SolviX-IoT/nou_hub_senzoor_pairing/ISTORIC.md

# ISTORIC — SolviX HUB + SENZOR

> Arhiva proiectului: **de ce** arata codul asa cum arata. Nu se incarca
> automat in context — se deschide cand ai nevoie de motivul din spatele unei
> decizii, cand un simptom seamana cu ceva ce s-a mai intamplat, sau cand un
> mesaj de commit citeaza o eticheta `F-0xx`.
>
> Referinta activa (pini, protocol, reguli) este in [CLAUDE.md](CLAUDE.md).
> Starea de acum (cifre, versiuni de format) este in [MEMORY.md](MEMORY.md).
>
> **Nicio intrare nu se sterge.** Ce nu mai este valabil se marcheaza
> *ISTORIC*, ca etichetele din mesajele de commit sa ramana rezolvabile.

---

## 1. Constrangerile care au modelat implementarea

Acestea vin din hardware-ul real si explica de ce solutia nu arata ca o
retea LoRa "de manual".

### 1.1. Flash si RAM foarte mici pe senzor — cifre masurate, nu estimate

`PIC16LF1508` are **4096 de cuvinte de flash si 256 de octeti de RAM**
(`ROMSIZE=1000`, `RAMBANK=20-7F,A0-EF,120-16F` in fisierul de device support
al lui XC8: 240 de octeti bancati + 16 comuni). O versiune anterioara a
documentatiei scria 512 B de RAM — era gresit, si din acea eroare a pornit
toata problema de incadrare (F-025).

**Aici s-a consumat toata marja, si de aceea nu mai exista criptografie in
proiect.** Istoricul incadrarii:

| varianta | flash (words) | RAM (octeti) |
|---|---|---|
| AES-128, cum a fost scrisa initial, `-O2` | 5426 | 446 |
| AES cu toate solutiile de rezerva aplicate simultan | 4325 | 286 |
| XTEA-128, dupa F-024 | 3761 | 250 |
| XTEA + pairing manual + somn + 5 senzori | 3876 | 232 |
| **fara criptografie (acum)** | **2395** | **95** |

AES nu incapea nici macar cu toate solutiile de rezerva: doar cele doua tabele
de substitutie ocupa 512 cuvinte, un sfert din tot flash-ul, inainte de orice
linie de cod (F-024). XTEA-128 a incaput, dar la 3876 din 3968 de cuvinte
utilizabile — **92 de cuvinte marja** — nu mai incapea nicio functionalitate
noua. La 2026-08-29 criptografia a fost scoasa (F-038), ceea ce a eliberat
**1481 de cuvinte si 137 de octeti**.

**Pretul: reteaua NU mai este autentificata.** Nu exista MIC, cheie sau nonce.
Oricine are un radio LoRa cu aceiasi parametri poate injecta o temperatura
falsa pentru orice senzor, poate dezinrola orice placa cu patru octeti
(`A5 13 <DevAddr> 02`), poate inrola o placa falsa cat timp fereastra de
pairing este deschisa (DevEUI-ul este ghicibil: `"SOLVIX" | 0x00 | numar`), si
poate rejuca orice pachet capturat. Singura limitare ramasa pe calea de date
este frame counter-ul strict crescator. In plus, `RegSyncWord` ramane `0x12`,
valoarea implicita a bibliotecii: inainte, MIC-ul filtra si emitatorii straini
care nimereau aceiasi parametri.

**Nu compensa cu nimic facut in casa.** Un pseudo-MIC de o suta de cuvinte
care nu opreste pe nimeni este mai rau decat o absenta onesta, fiindca cineva
se va baza pe el. Criptografia se reintroduce la upgrade-ul de microcontroller,
din commit-ul `a710142`, care este ultima stare care o contine.

**`-O2` ramane obligatoriu si regiunea HEF ramane rezervata.** Cu marja de
acum firmware-ul ar incapea probabil si cu `-O0`, dar cele doua setari nu se
schimba "fiindca oricum e loc": rezervarea HEF este singurul lucru care
garanteaza ca linkerul nu pune cod peste memoria ne-volatila (F-027).

Daca vreodata nu mai incape nici asa, ramane migrarea pe **PIC16LF1509**
(8K words, 512 B RAM), pin-compatibil — maparea de pini ramane valabila bit cu
bit, dar `HEF_BASE` devine `0x1F80`.

### 1.2. `SLEEP` nu este acelasi lucru cu taierea alimentarii

Distinctia asta decide schema frame counter-ului.

**Ce se intampla acum:** inrolat, senzorul executa `SLEEP` intre transmisii si
se trezeste pe watchdog. Durata **nu este aceeasi pe toate placile**:
`SLEEP_WAKEUPS_BASE` + `(DevAddr - 1)` + un jitter aleator de 0..3 treziri,
adica ~23 s pentru senzorul #1 fara jitter si pana la ~38 s pentru senzorul #5
cu jitter maxim (F-036). `SLEEP` pe PIC16 **pastreaza RAM-ul si registrele** —
procesorul doar isi opreste ceasul. Deci schema din F-022 ramane valabila
neschimbata: counter-ul traieste in RAM si se salveaza in HEF doar la fiecare
`FCNT_CHECKPOINT_EVERY` = 50 de pachete. **Nu** se scrie la fiecare ciclu de
somn; ar consuma HEF-ul degeaba.

**Ce ar fi altceva:** un regim in care **alimentarea se taie** intre transmisii
(un timer extern de tip PTC/latch care scoate VDD). Acolo fiecare trezire ar fi
un cold boot cu RAM-ul pierdut: counter-ul ar trebui scris la fiecare ciclu,
inelul de sloturi din HEF ar trebui marit (sau inlocuit cu un FRAM extern), iar
inrolarea ar trebui incadrata intr-o fereastra de alimentare. **Nu este cazul
astazi.**

Somnul se aplica doar in `DEV_STATE_OPERATING`. In `DEV_STATE_IDLE` si in
`DEV_STATE_JOINING` senzorul ramane treaz, fiindca acolo trebuie sa asculte
butonul 2 si sa poata face join.

### 1.3. Senzorul era doar TX, cu polling, fara DIO0 si fara RESET cablat

Pentru pairing a trebuit adaugat mod RX in driver: `LoRa_Receive()`, cu RX
continuu si polling pe `RxDone` / `PayloadCrcError`, citire din `RegFifo` de la
`FifoRxCurrentAddr`.

### 1.4. Pe hub, SPI este partajat cu ENC28J60

Tot traficul radio trece prin `SpiBus` (`claimLoRa()` / `SpiGuard`), receptia
este prin polling cu `receiveRaw()`, emisia binara prin `sendRaw()`, LED-urile
doar prin modulul `Leds`, si nu se apeleaza niciodata `LoRa.end()` /
`SPI.end()`.

---

## 2. Cronologie

| Data | Etichete | Ce s-a intamplat |
|---|---|---|
| — | F-001…F-020 | Mostenite din `teste-sistemcomplet/`: bug-urile de SPI partajat, de retea si de firmware de baza |
| — | F-021…F-023 | Faza de proiectare a pairing-ului: capcane prinse inainte de a ajunge pe placa |
| 2026-08-23 | F-024…F-029 | Pairing criptat, incadrat in PIC16LF1508: AES inlocuit cu XTEA-128, harta HEF corectata, regiunea HEF rezervata din linker |
| 2026-08-25 | F-030 | Pairing manual pe senzor, declansat din butonul 2 |
| 2026-08-25 | F-031 | Dezinrolare confirmata pe hub: RESET retrimis pana la tacere |
| 2026-08-25 | F-032 | Fereastra de downlink se deschide imediat dupa TX |
| 2026-08-25 | F-033 | Capcana de build: MPLAB X programa cod vechi |
| 2026-08-26 | *(fara F)* | TPL5110 scos din proiectare — vezi 2.1 |
| 2026-08-26 | F-034 | Somn intre transmisii pe senzor |
| 2026-08-26 | F-035…F-037 | Pana la 5 senzori pe acelasi hub |
| 2026-08-29 | F-038 | Criptografia scoasa, pairing-ul pastrat |
| 2026-09-01 | F-039…F-042 | Hub-ul nu mai este o suita de teste: runtime permanent, retea la pornire si bootstrap in cloud (health + provisioning) |
| 2026-09-01 | F-043 | Prima rulare cu serverul real: backoff-ul nu crestea si hub-ul isi intretinea singur blocajul de rate limiting |
| 2026-09-01 | F-044 | Campurile identitatii, dimensionate din estimare: lifecycleStatus nu incapea cu un caracter |
| 2026-09-01 | F-045 | Consola neblocanta nu executa nicio comanda pe "No line ending" - regresie din F-040 |
| 2026-09-01 | F-046 | Curatenie: consola redusa la 3 comenzi, cod mort scos, Blocked devine asteptare lunga |

### 2.1. 2026-08-26 — TPL5110 scos din proiectare *(fara eticheta F)*

Componenta nu mai este pe placa, deci a disparut si din cod: cele trei scrieri
de registre din `Board_Initialize()`, blocul de `#define` `TPL5110_DONE_*`,
notele din antetul lui `main.c`, testul `main_powercycle_test.c.bak` si
datasheet-ul din `senzor/Datasheets/` (folderul a ramas gol si a fost sters).

**RC1 este acum un pin liber si nu primeste cod:** ramane pe configuratia MCC
din `pins.c`, adica intrare analogica, ceea ce pentru un pin neconectat este
exact starea buna — bufferul digital de intrare este dezactivat, deci un nivel
flotant nu consuma curent.

F-011, F-012 si F-018 au fost marcate ISTORIC in loc sa fie sterse, ca
etichetele din mesajele de commit sa ramana rezolvabile; F-013 si F-014 raman
documentatie vie, fiindca lectiile lor nu tin de TPL5110.

Castigul de memorie este cel asteptat de la trei scrieri de registre:
**-5 cuvinte**, 3921 -> 3916.

**Ramas de facut manual:** `PINOUT_config.pdf` inca arata RC1 -> TPL5110.

---

## 3. Catalogul F-001 … F-046

Fiecare intrare spune **simptomul**, **cauza** si **fixul**, ca sa nu se repete
aceleasi greseli.

### F-001 — Modulele SPI se calca pe MISO (hub)
- **Simptom:** date de gunoi citite de la ENC28J60 sau de la LoRa, aleatoriu.
- **Cauza:** un slave SPI elibereaza MISO doar cat timp CS-ul lui este HIGH. La boot, ambele CS-uri erau flotante, deci ambele module puteau trage simultan de aceeasi linie.
- **Fix:** `SpiBus::begin()` face ambele CS-uri OUTPUT si HIGH **inainte** de orice trafic; `claimEthernet()` / `claimLoRa()` ridica CS-ul celuilalt modul inainte ca un test sa preia bus-ul.

### F-002 — `SPI.begin()` apelat de mai multe ori (hub)
- **Simptom:** maparea de pini se pierdea dupa ce un test reinitializa bus-ul.
- **Fix:** `SPI.begin()` se apeleaza **o singura data**, din `setup()`, cu ultimul argument `-1` ca driverul ESP32 sa nu preia niciun pin drept CS hardware.

### F-003 — `LoRa.end()` oprea si Ethernet-ul (hub)
- **Simptom:** dupa oprirea testului LoRa, ENC28J60 nu mai raspundea.
- **Cauza:** `LoRa.end()` inchide magistrala SPI a intregului ESP32.
- **Fix:** nu se apeleaza niciodata `LoRa.end()` sau `SPI.end()`; pentru oprirea radioului se foloseste `LoRa.sleep()`.

### F-004 — Acces SPI din intrerupere (hub)
- **Simptom:** coruperea transferurilor Ethernet aflate in desfasurare.
- **Cauza:** `LoRa.onReceive()` ruleaza callback-ul pe intreruperea de pe DIO0, care poate cadea fix in mijlocul unui transfer Ethernet.
- **Fix:** receptia se face prin **polling** cu `LoRa.parsePacket()`.

### F-005 — CS-ul Ethernet confundat cu GPIO5 (hub)
- **Simptom:** ENC28J60 mut.
- **Fix:** CS_ETH este **GPIO4**; GPIO5 este NSS-ul LoRa. Documentat explicit in `Config.h` si in README.

### F-006 — ICMP nu functioneaza pe ENC28J60 (hub)
- **Simptom:** ping-ul esua desi reteaua era in regula.
- **Cauza:** ENC28J60 nu raspunde la ICMP fara o librarie suplimentara, adesea instabila.
- **Fix:** testul de internet foloseste o cerere **HTTP GET**, care valideaza simultan DNS, rutare si TCP.

### F-007 — DHCP blocant (hub)
- **Simptom:** meniul serial devenea inutilizabil zeci de secunde.
- **Fix:** `Ethernet.begin(MAC, timeoutMs)` — al doilea parametru limiteaza asteptarea.

### F-008 — GPIO34/35 flotante (hub)
- **Simptom:** butoanele "se apasau singure".
- **Cauza:** GPIO34 si GPIO35 sunt **input-only** si nu au pull-up/pull-down intern.
- **Fix:** rezistor extern obligatoriu pe placa. Testul de butoane numara tranzitiile tocmai ca sa faca vizibil defectul. **In plus, in acest proiect:** butonul 1 (care deschide pairing-ul) este ascultat doar cand nu ruleaza niciun test sau cand ruleaza testul 8, ca zgomotul de pe o linie flotanta sa nu comute testele singur.

### F-009 — Mod SPI gresit pentru SX1276 (senzor)
- **Simptom:** `RegVersion` citea altceva decat `0x12`.
- **Cauza:** MSSP-ul pornea intr-un mod SPI care nu corespunde cu SX1276.
- **Fix:** dupa `Lora_SPI.Open(0)` se forteaza explicit **SPI mode 0**: `SSP1CON1bits.CKP = 0`, `SSP1STATbits.CKE = 1`.

### F-010 — Verificarea prezentei radioului (senzor)
- **Fix:** se citeste `RegVersion (0x42)` si se cere `0x12`. Daca nu se potriveste, versiunea citita se **clipeste pe LED in hexazecimal** (`LoRa_ShowVersionError`), in loc sa se blocheze mut.

### F-011 — DONE ignorat de TPL5110 (senzor)
> **ISTORIC.** TPL5110 a fost scos din proiectare la 2026-08-26 si nu mai
> este pe placa. Intrarea se pastreaza pentru trasabilitatea etichetelor
> F-0xx din mesajele de commit; codul descris aici nu mai exista.
- **Simptom:** placa nu se oprea la apasarea butonului.
- **Cauza:** TPL5110, sectiunea 8.5.2 din datasheet: "DONE signals received while the DELAY/M_DRV is HIGH are ignored". M_DRV are 20 ms de debounce pe ambele fronturi.
- **Fix:** se asteapta eliberarea butonului, apoi `TPL5110_MDRV_SETTLE_MS = 60 ms`, abia apoi se semnaleaza DONE.

### F-012 — Un singur front DONE nu e suficient (senzor)
> **ISTORIC.** Vezi nota de la F-011: TPL5110 nu mai este pe placa.
- **Cauza:** DONE este declansat pe front (min. 100 ns) si doar primul front dintr-un interval este procesat.
- **Fix:** se trimit **10 pulsuri** (`TPL5110_DONE_PULSES`) in loc de un singur nivel.

### F-013 — Blocaj in SPI daca MSSP e dezactivat (senzor)
- **Simptom:** apasarea butonului bloca firmware-ul.
- **Cauza:** `SPI1_ByteExchange` asteapta `SSP1IF` la nesfarsit daca MSSP-ul este oprit.
- **Fix:** niciun acces SPI daca `loraReady == 0`. In acest proiect regula acopera si calea de pairing: bucla de JOINING nu emite si nu asculta daca radioul nu a raspuns.

### F-014 — Nu se distingea defectul de firmware de cel de cablaj (senzor)
- **Fix:** LED-ul de alimentare se aprinde imediat la start si nimic nu il mai atinge.

### F-015 — Bounce la butoane (senzor)
- **Fix:** `Button_Pressed()` citeste, asteapta 20 ms, reciteste; nepotrivirea inseamna bounce si se ignora.

### F-016 — Fara virgula mobila pe PIC16 (senzor)
- **Problema:** formula Steinhart / beta cere `log()` si `exp()`; libraria math in virgula mobila nu incape in cei 4K words alaturi de driverul LoRa.
- **Fix:** conversie prin **tabel de cautare cu interpolare liniara** in aritmetica pe intregi: 25 de intrari de la −20 °C la +100 °C, pas de 5 °C.

### F-017 — Fara timer hardware (senzor)
- **Constrangere impusa:** Timer0/1/2 nu sunt configurate.
- **Fix:** intervalul de transmisie se obtine cu o bucla software de pasi de 10 ms, care permite si verificarea butonului intre pasi.

### F-018 — RC1 (DONE) trebuie tinut LOW cand timerul nu e folosit (senzor)
> **ISTORIC.** TPL5110 a fost scos din proiectare la 2026-08-26. RC1 este
> acum un pin liber, fara cod in `main.c`: ramane pe intrare analogica din
> configuratia MCC, ceea ce pentru un pin neconectat este starea corecta —
> bufferul digital este dezactivat, deci un nivel flotant nu consuma curent.
- **Problema:** codul nu face power-cycle, dar RC1 este in continuare legat la pinul DONE al TPL5110. Lasat flotant sau HIGH, ar putea taia alimentarea in mijlocul unei transmisii — sau in mijlocul unei scrieri in HEF, ceea ce ar lasa un rand pe jumatate scris.
- **Fix:** `main()` configureaza RC1 ca iesire digitala si il tine **LOW permanent**.

### F-019 — `String` nu poate transporta un pachet binar (hub)
- **Simptom:** un pachet care contine octetul `0x00` ar fi fost trunchiat la receptie.
- **Cauza:** `LoRaRadio::receive()` acumuleaza octetii intr-un `String`, care trateaza `0x00` drept terminator de sir.
- **Fix:** `LoRaRadio::receiveRaw()`, care scrie intr-un buffer de `uint8_t`. **Extins in acest proiect pe emisie:** `JOIN_ACCEPT` si `CMD_DOWN` contin `0x00` in padding si in contoare, deci a fost adaugat si `LoRaRadio::sendRaw()`. `sendText()` ramane pentru testele de legatura cu text.

### F-020 — Cod nou livrat in foldere paralele in loc sa extinda proiectul
- **Simptom:** functionalitatea de temperatura a fost livrata initial ca `senzor_temp/` si `hub_lora_rx/`, doua foldere noi langa `senzor/` si `hub/`.
- **Cauza:** structura existenta nu a fost respectata. Rezultatul erau doua seturi de definitii de pini si doua initializari de driver, care ar fi divergat la prima modificare.
- **Fix:** codul a fost mutat in proiectele existente. **Regula pentru viitor, respectata si de pairing:** functionalitatea noua intra in `senzor/main.c` si in module noi din `hub/SolvixHub_Tests/`; nu se creeaza foldere paralele.

### F-021 — Un fisier `Crypto.h` propriu ar fi ascuns biblioteca `Crypto` (hub)
> **ISTORIC.** Wrapper-ul `HubCrypto.*` a disparut odata cu criptografia
> (F-038). Lectia despre calea de include ramane valabila pentru orice
> fisier nou din folderul sketch-ului.
- **Simptom (anticipat la proiectare):** eroare de compilare in interiorul bibliotecii `Crypto` (Rhys Weatherley), care nu isi mai gaseste propriile declaratii.
- **Cauza:** Arduino IDE pune folderul sketch-ului **inaintea** folderelor de biblioteci in calea de include. Un `Crypto.h` al nostru ar fi fost gasit primul si de biblioteca, atunci cand ea include `<Crypto.h>`.
- **Fix:** wrapper-ul s-a numit `HubCrypto.h` / `HubCrypto.cpp`, cu motivul scris in antetul fisierului.

### F-022 — Scrierea frame counter-ului la fiecare pachet ar consuma HEF-ul (senzor)
- **Simptom (anticipat):** dupa cateva luni de functionare, scrierile in HEF ar fi inceput sa esueze in tacere, iar senzorul ar fi reluat pairing-ul la fiecare pornire.
- **Cauza:** HEF suporta ~100.000 de cicluri de stergere/scriere pe rand. Un pachet la 5 secunde inseamna 17.280 de scrieri pe zi: sub 6 zile pe un singur rand.
- **Fix:** counter-ul sta in RAM (senzorul e alimentat permanent) si se salveaza doar la fiecare `FCNT_CHECKPOINT_EVERY` = 50 de pachete, prin rotatie in sloturile inelului. La cold boot se sare inainte cu 50, ca sa nu se reutilizeze nicio valoare. Rezulta ~345 de scrieri pe zi impartite la 2 randuri (vezi F-026 pentru de ce sunt 2, nu 4), adica peste 500 de zile pe rand.

### F-023 — Payload-ul decriptat nu trecea de checksum, fara niciun indiciu (hub)
> **ISTORIC.** `PAIRING_ENCRYPT_PAYLOAD` nu mai exista (F-038), deci cauza
> descrisa aici nu mai poate aparea.
- **Simptom (anticipat la proiectare):** MIC valid, deci pachetul chiar vine de la senzorul inrolat, dar `decode()` il respinge. Simptomul arata identic cu un senzor defect.
- **Cauza posibila:** `PAIRING_ENCRYPT_PAYLOAD` are valori diferite pe hub si pe senzor, deci hub-ul "decripteaza" un text care era deja in clar (sau invers).
- **Fix:** `TestPairing` trata acest caz separat de un MIC gresit, spunea explicit ce sa verifice si afisa octetii obtinuti.

### F-024 — AES-128 nu incape in PIC16LF1508
*(2026-08-23)*
- **Simptom:** proiectul nu link-edita deloc pentru `16LF1508`. Prima eroare era in RAM (`no space for auto/param main@tempPacket`), iar dupa ce se elibera RAM aparea un val de `can't find N words for psect ... in class CODE`.
- **Cauza:** firmware-ul cu AES-128 + AES-CMAC + AES-CTR cere **5426 de cuvinte de program si 446 de octeti de RAM** (masurat cu `xc8-cc` v3.10, `-O2`, compiland pentru `16LF1509` care are acelasi nucleu dar memorie mai mare — pe `16LF1508` link-editarea esueaza si nu da nicio cifra). Device-ul are 4096 de cuvinte si 256 de octeti. Nici macar cu toate cele trei solutii de rezerva prevazute in proiectare aplicate simultan nu se cobora sub **4325 de cuvinte / 286 de octeti**. Numai cele doua tabele de substitutie ale AES ocupa 512 cuvinte.
- **Fix:** cifrul a fost inlocuit cu **XTEA-128** (bloc de 64 de biti, cheie de 128, 32 de runde, `DELTA = 0x9E3779B9`). XTEA nu are niciun tabel si are nevoie doar de cifrare, fiindca MIC-ul (CBC-MAC) si criptarea (CTR) se construiesc amandoua peste ea. Rezultat: **3761 de cuvinte si 250 de octeti**, cu pairing-ul, cheia de sesiune, anti-replay-ul si criptarea payload-ului toate pastrate. `JOIN_ACCEPT` s-a scurtat de la 22 la 10 octeti.
- **De retinut:** CBC-MAC-ul simplu (fara subcheile CMAC) era sigur acolo **doar** pentru ca fiecare tip de mesaj avea lungime fixa si octetul `TYPE` se afla in primul bloc acoperit. Daca se reintroduce cifrul si se adauga un mesaj de lungime variabila, constructia trebuie schimbata.

### F-025 — RAM-ul lui PIC16LF1508 documentat gresit ca 512 B
*(2026-08-23)*
- **Simptom:** toate estimarile de incadrare erau optimiste cu un factor de doi, iar buffer-ele fusesera dimensionate dupa ele.
- **Cauza:** documentatia si comentariile din `main.c` scriau 512 B. In realitate `RAMBANK=20-7F,A0-EF,120-16F` inseamna **240 de octeti bancati + 16 comuni = 256**. (512 B are `PIC16LF1509`.)
- **Fix:** cifra a fost corectata peste tot, iar consumul a fost taiat acolo unde chiar conta: cheia extinsa a disparut (XTEA nu are program de chei), `hefRowBuffer` tine doar octetii folositi in loc de tot randul de 32 (restul latch-urilor primesc `0xFF` direct in `HEF_WriteRow`), iar buffer-ele de pachete au fost dimensionate dupa noile lungimi.

### F-026 — Randul de HEF are 32 de cuvinte, nu 16
*(2026-08-23)*
- **Simptom (prins inainte de a ajunge pe placa):** harta HEF folosea 8 regiuni de cate 16 cuvinte, iar scrierea "randului" de la `0x0F90` ar fi sters de fapt tot blocul `0x0F80`–`0x0F9F` — adica DevEUI-ul odata cu el. Senzorul si-ar fi pierdut identitatea la prima pornire, tacut.
- **Cauza:** dimensiunea randului fusese scrisa ca **presupunere** in proiectare si nu fusese verificata.
- **Fix:** valoarea reala este in fisierul de device support al lui XC8, `PIC12-16F1xxx_DFP/.../dat/ini/16lf1508.ini`: `FLASH_ERASE=20` si `FLASH_WRITE=20`, hexazecimal, adica **32 de cuvinte**. `HEF_ROW_WORDS` este acum 32, iar harta are 4 randuri. Ca efect secundar bun, o inrolare inseamna o singura stergere+scriere in loc de doua.

### F-027 — Linkerul plasa cod chiar in regiunea HEF
*(2026-08-23)*
- **Simptom (demonstrat pe fisierul de simboluri, inainte de a ajunge pe placa):** `Packet_BuildDataEnc` se termina la `0x0F9A` si `SPI1_Open` incepea acolo — adica exact peste `0x0F80`–`0x0FFF`. Prima scriere in HEF si-ar fi sters propriul cod si placa ar fi devenit un caramizi la prima inrolare.
- **Cauza:** proprietatea `code-model-rom` a proiectului MPLAB X era goala, deci linkerul avea voie sa foloseasca toata memoria de program, inclusiv ultimele 128 de cuvinte pe care firmware-ul le foloseste ca memorie ne-volatila.
- **Fix:** `code-model-rom = default,-f80-fff` in `senzor/nbproject/configurations.xml` (echivalentul lui `--ROM=default,-f80-fff`). Verificat dupa fix: ultima instructiune este la `0x0F7F`, deci regiunea HEF este curata. **Aceeasi rezervare trebuie refacuta daca cineva recreeaza proiectul MPLAB X de la zero.**

### F-028 — Aritmetica pe 32 de biti manca flash-ul pe PIC16
*(2026-08-23)*
- **Simptom:** functii banale ieseau enorme: `Xtea_LoadKey` 126 de cuvinte, `Nvm_LoadFrameCounter` 194, `NTC_AdcToTempX100` 207 plus inca 172 pentru rutinele `___aldiv` si `___lmul` din biblioteca.
- **Cauza:** PIC16 are un acumulator de 8 biti. Fiecare deplasare a unui `uint32` cu un numar de pozitii devine o bucla din biblioteca XC8, iar o impartire pe 32 de biti este o rutina intreaga. Impachetarea si despachetarea big-endian scrise "cu shift-uri" costau singure peste 300 de cuvinte.
- **Fix, in doua locuri:**
  1. **Cifrul** folosea uniunea `Word32 { uint32_t word; uint8_t byte[4]; }`. Conversiile big-endian devin mutari de octeti, fara nicio deplasare pe 32 de biti.
  2. **Interpolarea NTC** se face integral pe 16 biti, in doi pasi (`frac = (high-adc)*64/span`, apoi `frac*500/64`), ca intermediarul sa ramana sub 65.535. Dispar si `___aldiv`, si `___lmul`. Cuantizarea introdusa este de 500/64 ≈ 0,08 °C — cu un ordin de marime sub toleranta unui NTC de 1%.
- **Rezultat:** 4035 -> 3761 de cuvinte, adica exact marja care a facut posibila rezervarea regiunii HEF din F-027.
- **De retinut:** pe acest device, orice `int32_t` nou introdus in codul fierbinte trebuie privit ca o cheltuiala de zeci-sute de cuvinte, nu ca o alegere de tip. `Word32` a supravietuit scoaterii cifrului — o folosesc cele trei functii de frame counter (vezi capcana 1 din F-038).

### F-029 — Configuratia de DEBUG nu incapea: depanatorul isi ia 16 octeti de RAM
*(2026-08-23)*
- **Simptom:** `Build` mergea, dar `Debug Project` esua cu `could not find space (4 bytes) for variable _fcntSinceCheckpoint`.
- **Cauza, doua lucruri suprapuse:**
  1. MPLAB X adauga la build-ul de depanare `-mram=default,-160-16f`, adica **rezerva 16 octeti** (`0x160`-`0x16F`, valoarea `ICD3RAM` din fisierul de device support) pentru Snap/PICkit. Din cei 240 de octeti bancati raman 224, iar firmware-ul folosea 250.
  2. Makefile-ul generat continea `-O0`, fiindca MPLAB X il **rescrie** din modelul lui intern la fiecare build. Editarea lui `configurations.xml` cu proiectul DESCHIS in IDE nu are efect — setarile trebuie facute din interfata, sau IDE-ul trebuie inchis inainte.
- **Fix:** 19 octeti de RAM eliberati: `AppKey` nu s-a mai tinut in RAM, ci s-a citit direct din HEF in cifru (`-16 octeti`, `+82` cuvinte de program); `fcntSinceCheckpoint` a devenit `uint8_t` (`-3 octeti`).
- **De retinut:** daca `Debug Project` incepe iar sa dea `could not find space`, verifica INTAI ca optimizarea este `-O2` in fereastra de proprietati a proiectului, nu in fisiere — IDE-ul le suprascrie.

### F-030 — Fiecare `__delay_ms()` cu o constanta noua costa ~25 de cuvinte
*(2026-08-25)*
- **Simptom:** adaugarea pairing-ului manual (o functie care numara apasarea butonului 2 si o bucla de asteptare cu LED2 clipind) a umflat firmware-ul cu **173 de cuvinte**, de la 3843 la 4016, iar link-editarea a picat cu `can't find N words for psect ... in class CODE` — adica exact esecul din F-024, dar din alta cauza.
- **Cauza:** `__delay_ms()` nu este o functie, ci o macro care emite o bucla de intarziere **inline la fiecare loc de apel**. Cele doua bucle noi aveau intre ele patru intarzieri distincte (100 ms, 20 ms, 10 ms si inca un 100 ms), fiecare cu propriul cod generat. Din cele 173 de cuvinte, peste 100 erau bucle de intarziere duplicate, nu logica.
- **Fix, trei masuri:**
  1. o singura functie `Pairing_BlinkStep()` detine **unicul** `__delay_ms(PAIR_HOLD_TICK_MS)` din firmware, iar ambele bucle de pairing o apeleaza;
  2. numaratoarea apasarii si asteptarea eliberarii butonului au fost unificate intr-o singura bucla `while (apasat)`, cu un contor care se opreste la prag — deci un singur loc de intarziere in loc de trei;
  3. debounce-ul separat la 20 ms pentru RC5 a fost scos: bucla reciteste oricum pinul de 30 de ori la 100 ms distanta si abandoneaza la prima citire LOW, ceea ce este un filtru de bounce mai strict decat cel din `Button_Pressed()` (F-015), nu mai slab.
- **Rezultat:** 4016 -> **3936** de cuvinte, adica sub cele 3968 utilizabile.
- **Comportamentul rezultat:** fara sesiune, senzorul sta in `DEV_STATE_IDLE` si tace; fereastra de inrolare se deschide tinand butonul 2 (RC5) apasat ~3 secunde si se inchide dupa `PAIRING_MAX_ATTEMPTS` = 10 incercari, cu LED2 clipind cat este deschisa. `CMD_DOWN(RESET)` duce senzorul in repaus, nu inapoi in pairing.
- **De retinut:** pe acest device, o intarziere inline cu o valoare noua se pune la socoteala ca o functie de ~25 de cuvinte. Cand ai nevoie de temporizare in doua locuri, imparte acelasi pas, nu copia randul.

### F-031 — `remove` era "trimite si uita": un RESET pierdut lasa senzorul blocat in retea pe veci
*(2026-08-25)*
- **Simptom:** dupa `remove <DevEUI>`, senzorul continua sa emita si nu mai poate fi oprit din hub. Pe Serial curge la nesfarsit `[DATA] IGNORAT: DevAddr 0x.. nu este inrolat.`, iar `remove <DevEUI>` raspunde `Nu exista niciun device inrolat`, fiindca device-ul nu mai este in registru. Singura iesire ramane fizica: trei secunde pe butonul 2 al senzorului. Cel putin o placa a ajuns in starea asta.
- **Cauza:** `handleEncryptedData()` trimitea `CMD_DOWN(RESET)` **o singura data** si stergea imediat inregistrarea cu `removeByEui()`, fara nicio confirmare. Downlink-ul are o singura sansa: senzorul asculta doar `DOWNLINK_WINDOW_MS` = 600 ms dupa fiecare transmisie. Daca acel pachet se pierde — coliziune, fereastra ratata, orice — senzorul isi pastreaza starea si continua sa emita, iar hub-ul tocmai a aruncat singura copie a cheii cu care ar fi putut compune un alt `CMD_DOWN` valid pentru el. Dezinrolarea era presupusa, nu verificata.
- **Fix — stergerea se face pe dovada, nu pe speranta:**
  1. inregistrarea **nu** se mai sterge la trimiterea RESET-ului;
  2. la **fiecare** pachet primit de la un device marcat se retrimite `RESET`, cu `downCounter` si `resetAttempts` incrementate — un senzor care inca emite este dovada ca nu a primit comanda; pachetul nu se mai decodeaza si nu se mai numara ca date valide;
  3. inregistrarea dispare abia cand senzorul **tace** `REMOVE_CONFIRM_SILENCE_MS` de la ultimul RESET — tacerea este exact semnalul ca a ajuns in `DEV_STATE_IDLE` (F-030). Verificarea ruleaza in `tick()`, prin `servicePendingRemovals()`, fara `delay()` si fara timer nou;
  4. `remove` pe un device care nu a trimis niciodata nimic (`hasUplink` fals) este refuzat, cu explicatie: RESET-ul nu are cum sa plece daca senzorul nu vorbeste, iar marcarea ar bloca inregistrarea la nesfarsit. Operatorul alege intre a porni senzorul si `force`;
  5. cand sosesc pachete de la un `DevAddr` neinrolat, hub-ul spune — rar, o data la `PAIRING_UNKNOWN_HINT_EVERY` pachete — cum se recupereaza senzorul, pentru placile ramase blocate de varianta veche.
- **Capcana prinsa in timpul fixului:** `resetSentMs` trebuie pus pe **0** la incarcarea din NVS, exact ca `lastSeenMs`. Amandoua sunt relative la `millis()`, deci la pornirea hub-ului o valoare veche minus un `millis()` mic ar da o diferenta uriasa si dezinrolarea ar aparea drept confirmata instantaneu, fara ca vreun RESET sa fi plecat. Zero inseamna acum "niciun RESET in sesiunea asta", iar confirmarea prin tacere refuza sa se pronunte in acel caz si asteapta un pachet.
- **Consecinta:** `DeviceRecord` s-a modificat, deci `REGISTRY_BLOB_VERSION` a trecut pe **2** — si, ca urmare, senzorii deja inrolati au trebuit reinrolati o data.
- **De retinut:** un downlink fara confirmare nu este o comanda, este o speranta. Cand hub-ul arunca starea de care depinde reincercarea, pierderea unui singur pachet devine definitiva.

### F-032 — Pulsul LED-ului de date facea senzorul surd la downlink
*(2026-08-25)*
- **Simptom:** hub-ul retrimitea `CMD_DOWN(RESET)` la fiecare pachet, cu `incercarea 1`, `2`, `3`, `4`, `5`..., iar senzorul continua netulburat sa emita date. Nici `ACK`-urile nu ajungeau vreodata: LED2 nu pulsa niciodata dupa o transmisie, desi `PAIRING_SEND_ACK` era 1. Inrolarea, in schimb, mergea din prima de fiecare data.
- **Cauza:** in bucla de date, intre `LoRa_SendBuffer()` si `LoRa_Receive()` statea `Led_PulseData()`, care este un puls **blocant** de `LED_PULSE_MS` = **150 ms**. Fereastra de receptie a senzorului se deschidea deci abia la 150 ms dupa terminarea propriei transmisii, iar hub-ul raspunde mult mai devreme: cateva milisecunde de procesare si de scris pe Serial, plus ~41 ms de timp pe aer la SF7/BW125/CR4-5. Downlink-ul era complet terminat pe la ~55 ms, cand senzorul inca tinea LED-ul aprins cu radioul in standby. **Niciun downlink din calea de date nu a functionat vreodata.** Asimetria cu inrolarea este exact dovada: `Join_Attempt()` trece direct de la `LoRa_SendBuffer()` la `LoRa_Receive()`, fara nicio intarziere, si de aceea `JOIN_ACCEPT` se prindea mereu.
- **Fix:** LED1 se aprinde inainte de fereastra si se stinge dupa ea, cu doua scrieri simple in `LATC`, deci receptia porneste imediat dupa TX. `Led_PulseData()` a ramas fara apelanti si a fost scoasa. Vizual, LED1 sta aprins cat dureaza fereastra de downlink in loc de 150 ms fixe — tot o clipire per pachet. Ca efect secundar, firmware-ul s-a micsorat cu 15 cuvinte: 3936 -> **3921**.
- **De retinut:** intre o transmisie si fereastra ei de receptie nu are voie sa stea NIMIC blocant — nici LED-uri, nici scrieri in HEF, nici masuratori. Fereastra este singura ocazie in care celalalt capat poate vorbi, si se inchide singura. Orice `__delay_ms()` pus acolo "doar pentru feedback vizual" costa exact functionalitatea.

### F-033 — Build de verificare in `build/`+`dist/` lasa MPLAB X cu o stare veche
*(2026-08-25)*
- **Simptom:** doua "bug-uri" care nu existau. Intai butonul 2 parea mort: se tinea RC5 apasat trei secunde si nu se intampla nimic, desi F-030 era in `main.c`. Apoi, dupa o reprogramare, senzorul parea ca se inroleaza **singur**, fara nicio apasare — exact comportamentul de dinainte de F-030. S-a cautat in maparea pinilor, in pull-up-uri si in cablaj; nu era nimic acolo.
- **Cauza:** placa fusese programata cu **cod vechi**. Ca sa se verifice incadrarea in flash, firmware-ul fusese compilat cu `xc8-cc` chemat direct, iar iesirea scrisa fix in `senzor/build/` si `senzor/dist/` — directoarele de lucru ale lui MPLAB X. Numele obiectelor nu erau cele pe care le asteapta `Makefile-default.mk`, iar in `dist/` ramanea un `senzor.production.elf` mai nou decat sursele. Build-ul IDE-ului a ramas deci intr-o stare incoerenta si a produs un `.hex` care nu corespundea cu `main.c` de pe disc. Sursa era corecta tot timpul.
- **Fix:** *Clean* pe proiect in MPLAB X, apoi *Make and Program Device*. Pentru viitor: un build de verificare facut din afara IDE-ului **nu scrie in `senzor/build/` sau `senzor/dist/`** — se da o alta destinatie (un director temporar). Daca s-a scris totusi acolo, se face obligatoriu *Clean* inainte de urmatoarea programare.
- **Cum se verifica in trei secunde ce s-a programat:** raportul de memorie din fereastra de build, sau `senzor/dist/default/production/senzor.production.mum`, trebuie sa arate cifra curenta din [MEMORY.md](MEMORY.md). Alta cifra inseamna alt cod decat cel din `main.c`, si nicio cautare in schema nu are rost pana nu se potriveste.
- **Cu cinci placi identice, verifica si CE numar are placa programata:** da `sensors` pe hub si uita-te ca senzorul sa apara pe randul asteptat. Doua placi programate din greseala cu acelasi `SENSOR_NODE_ID` au acelasi `DevEUI`, deci a doua o inlocuieste pe prima in registru la inrolare. `provisioned` arata ce numar ar trebui sa aiba fiecare `DevEUI`.
- **De retinut:** cand o placa se poarta ca o versiune anterioara a firmware-ului, prima intrebare nu este "ce am gresit in cod", ci "ce cod este de fapt pe cip".

### F-034 — Somnul senzorului ar fi rupt confirmarea dezinrolarii de pe hub
*(2026-08-26)*
- **Simptom (prins la proiectare, inainte de a ajunge pe placa):** dupa introducerea somnului de ~30 s, un `remove <DevEUI>` ar fi raportat `DEZINROLARE CONFIRMATA` in mijlocul unui somn normal, fara ca senzorul sa fi primit vreun `RESET`. La trezire senzorul ar fi continuat sa emita cu cheia veche, iar hub-ul — care tocmai stersese inregistrarea si cheia — nu l-ar mai fi putut opri niciodata. Adica exact fundatura reparata de F-031, de data asta fara nicio iesire din hub.
- **Cauza:** `REMOVE_CONFIRM_SILENCE_MS` era 20 s, calibrata explicit pentru "patru transmisii ratate la rand" la un interval de transmisie de 5 s. Mecanismul din F-031 foloseste **tacerea** ca dovada ca senzorul a primit `RESET`-ul si a intrat in repaus. Un senzor care doarme tace si el, si tace mai mult decat fereastra: 30 s de somn > 20 s de fereastra, deci prima confirmare ar fi cazut inainte de prima trezire.
- **Fix:** `REMOVE_CONFIRM_SILENCE_MS` a urcat la **120 s**, adica patru cicluri de somn nominale. Perechea `SLEEP_WAKEUPS` (senzor) <-> `REMOVE_CONFIRM_SILENCE_MS` (hub) a intrat in lista constantelor care se schimba obligatoriu pe ambele capete.
- **Ce a costat incadrarea:** somnul in sine a costat 27 de cuvinte, dar nu incapea. A fost nevoie intai de o faza de curatenie: `SPI1_Open` a iesit din legatura (MSSP-ul se deschide scriind direct cele cinci registre, in loc sa indexeze tabelul MCC pentru o singura configuratie), iar frame counter-ul a trecut pe uniunea `Word32` in cele trei locuri unde se impacheta big-endian cu deplasari pe 32 de biti — economia pe care F-028 o lasase scrisa ca "inca netratat". Cele doua au eliberat impreuna **186 de cuvinte**, 3916 -> 3730, iar cu somnul firmware-ul a ajuns la **3757**.
- **De ce e fragmentat somnul:** RC5 este pe PORTC, iar `pic16lf1508.h` nu are niciun registru `IOCC*` — interrupt-on-change exista doar pe PORTA si PORTB, deci un senzor adormit nu poate fi trezit de buton. Somnul se imparte in reprize de ~2,11 s, cu butoanele citite la fiecare trezire. `WDTE` a trecut de la `OFF` la `SWDTEN`, ca watchdog-ul sa fie pornit numai in jurul lui `SLEEP`.
- **Continuare, F-036:** `SLEEP_WAKEUPS` nu mai exista ca atare. Somnul este acum `SLEEP_WAKEUPS_BASE` + `(DevAddr - 1)` + jitter, deci fiecare senzor doarme altfel si cel mai lung ciclu a crescut la ~44 s. `REMOVE_CONFIRM_SILENCE_MS` a urcat corespunzator la 180 s, si tot atunci a intrat in regula si `SENSOR_OFFLINE_MS`.
- **De retinut:** o schimbare care pare locala pe un nod poate invalida tacut o presupunere de temporizare de pe celalalt. Aici presupunerea nu era scrisa intr-un `#define` comun, ci intr-un **comentariu** care spunea "patru transmisii la 5 secunde" — si comentariile nu dau erori de compilare cand realitatea se schimba sub ele. Orice mecanism care foloseste **absenta** unui semnal drept dovada trebuie recitit ori de cate ori se schimba ritmul in care acel semnal apare.

### F-035 — Fereastra de downlink putea fi consumata de pachetul altui senzor
*(2026-08-26)*
- **Simptom (prins la proiectare, inainte de a pune a doua placa in retea):** cu doi sau mai multi senzori inrolati, `remove <DevEUI>` ar fi raportat `incercarea 1`, `2`, `3`... la nesfarsit pe un senzor perfect sanatos, iar ACK-urile ar fi ajuns doar din cand in cand. Adica simptomul lui F-032, dupa ce F-032 fusese reparat — si de aceea merita scris separat: are alta cauza.
- **Cauza:** `LoRa_Receive()` se intorcea la **primul** pachet cu CRC bun din fereastra, oricare ar fi fost el. Cat timp exista un singur senzor, orice pachet auzit in fereastra proprie era, prin constructie, raspunsul hub-ului. Cu mai multi senzori, in cele 600 ms ale lui A poate intra la fel de bine ACK-ul trimis lui B: functia se intorcea cu acel pachet, parserul il respingea corect (adresa nu se potriveste), dar **fereastra se inchisese deja**. Un downlink are o singura sansa per ciclu, deci pe calea de dezinrolare asta reproduce exact fundatura din F-031.
- **Fix:** `LoRa_Receive()` a primit parametrul `wantType`. Un pachet care nu are magic-ul nostru, nu are tipul cerut, sau — pentru `CMD_DOWN` — nu are `devAddr` nostru, este aruncat **si receptia continua cu timpul ramas**, exact ca la un CRC gresit.
- **Al doilea filtru, gratuit:** `RegMaxPayloadLength` = `LORA_RX_BUFFER_LEN`, deci modemul arunca singur, in hardware, pachetele mai lungi decat cel mai lung pe care senzorul il PRIMESTE. Vezi capcana 3 din F-038 pentru de ce valoarea trebuie recalculata la fiecare schimbare de lungimi.
- **Ce a ramas netratat atunci, dinadins:** in fereastra de `JOIN_ACCEPT` nu se putea filtra pe adresa, fiindca `DevAddr` circula acolo cifrat. Doi senzori care se inrolau in aceeasi secunda isi puteau fura reciproc fereastra. **Rezolvat de F-038:** fara cifru, `DevAddr` circula in clar in `JOIN_ACCEPT`, iar senzorul stie de la compilare ce numar asteapta.
- **De retinut:** o functie care asteapta "un pachet" a fost scrisa, fara sa o spuna, pentru o retea cu **un singur** partener de discutie. Cand apare al doilea, presupunerea nu da nicio eroare de compilare.

### F-036 — Acelasi interval de somn pe toate placile inseamna coliziune blocata
*(2026-08-26)*
- **Simptom (prins la proiectare):** doi senzori ar fi disparut **in perechi** din jurnalul hub-ului, sistematic si fara nicio eroare vizibila — nici MIC gresit, nici replay, nici pachet strain. Pur si simplu nu ar mai fi venit nimic de la ei, in timp ce ceilalti trei ar fi mers impecabil.
- **Cauza:** `SLEEP_WAKEUPS` era o constanta de compilare, aceeasi pe toate placile. Doua pachete care se suprapun in aer se pierd amandoua (SF7/BW125 nu are captura garantata la puteri apropiate). Coliziunea intamplatoare nu e o problema — 0,15% ocupare per senzor — dar doi senzori cu **exact acelasi interval** care s-au ciocnit o data raman ciocniti la nesfarsit: se deplaseaza cu acelasi pas, deci nu se despart niciodata. Probabilitatea de a intra in starea asta este mica; iesirea din ea, fara nicio interventie, era **zero**.
- **Fix, doua masuri care se completeaza:**
  1. **interval propriu fiecarui senzor**, `SLEEP_WAKEUPS_BASE` (11) plus `(DevAddr - 1)`, deci 23,2 / 25,3 / 27,4 / 29,6 / 31,7 s nominal. Doi senzori ciocniti se despart de la sine dupa o perioada;
  2. **jitter aleator la fiecare ciclu**, 0..3 treziri dintr-un LFSR de 8 biti (`Rand8`), semanat din `DevEUI` si din frame counter-ul citit din HEF. Rupe si cazul in care doua placi ar nimeri acelasi numar de treziri, si pornirea simultana dupa o pana de curent, cand toate placile inrolate emit prima data in acelasi moment.

  Media pe cele 5 adrese ramane ~30,6 s, adica exact ritmul dinainte: s-a schimbat imprastierea, nu debitul. Cost: **+91 de cuvinte** si **+1 octet**, impreuna cu F-035 si cu blocul de provisioning per placa; verificarea de identitate din F-037 a mai luat 28, deci in total 3757 -> **3876**.
- **Consecinta obligatorie pe hub:** `REMOVE_CONFIRM_SILENCE_MS` a urcat de la 120 s la **180 s**. Senzorul #5 cu jitter maxim si LFINTOSC la limita de toleranta doarme ~44 s; fereastra de confirmare trebuie sa acopere patru astfel de cicluri, altfel se repeta F-034.
- **Capcana prinsa in timpul fixului:** contorul nou de **pachete pierdute** (goluri in frame counter) numara si saltul cu `FCNT_CHECKPOINT_EVERY` = 50 pe care senzorul il face la fiecare pornire la rece (F-022). O repornire ar fi aratat ca 50 de coliziuni, adica exact peste cifra dupa care se judeca daca senzorii se ciocnesc intre ei. Peste `SENSOR_FCNT_GAP_RESTART` = 20, hub-ul spune acum "a repornit" in loc sa adune pierderi: douazeci de pachete pierdute la rand ar insemna zece minute de tacere continua, iar la atata `SENSOR_OFFLINE_MS` ar fi raportat deja senzorul ca disparut.
- **De retinut:** cand mai multe noduri identice impart un canal, **egalitatea perfecta a perioadelor este o defectiune**, nu o virtute. Un sistem care nu are cum sa iasa dintr-o stare proasta este mai rau decat unul care intra in ea mai des dar se repara singur.

### F-037 — `DevAddr` alocat "prima adresa libera" nu putea fi scris pe cutie
*(2026-08-26)*
- **Simptom (prins la proiectare):** cu cinci placi identice in teren, operatorul nu ar fi avut cum sa stie care este care. Numarul afisat de hub ar fi depins de ordinea in care au fost pornite, s-ar fi schimbat dupa fiecare dezinrolare si reinrolare, si ar fi fost complet altul dupa o golire a registrului — de exemplu dupa un update care incrementeaza `REGISTRY_BLOB_VERSION`. Singurul identificator stabil ar fi ramas `DevEUI`, adica 16 cifre hexazecimale citite de pe ecran de fiecare data cand vrei sa stii a cui e temperatura.
- **Cauza:** `DeviceRegistry::allocateAddress()` intorcea prima adresa libera din `0x01`..`0xFE`. Cu un singur senzor asta insemna intotdeauna `0x01` si nu se vedea; cu cinci, numerotarea devine un accident al istoriei de pornire.
- **Fix:** `addressForEui()` intoarce **pozitia senzorului in tabelul `PROVISIONED_DEVICES_INIT` din `Config.h`, plus unu**. Tabelul este compilat in program, deci pozitia nu se poate pierde. Consecinte: randul 3 este "Senzor #3" indiferent de istorie, doua placi nu pot primi acelasi numar, iar numarul poate fi scris pe cutie. Aceeasi cifra se scrie si pe placa, ca `SENSOR_NODE_ID`, din care ies acolo `DevEUI` **si** slotul de somn din F-036 — deci numarul chiar face doua treburi, nu este o eticheta.
- **Ce s-a mai simplificat odata cu asta:** cele cinci firmware-uri difera printr-o singura linie. Inainte se editau la fiecare placa doua tabele de octeti, iar o singura cifra gresita in oricare dintre ele dadea acelasi simptom ca o cheie complet gresita: "MIC gresit", fara alt indiciu.
- **Cazul de tranzitie, tratat explicit:** daca in NVS ramane o inregistrare dintr-o versiune in care adresele se alocau in ordinea inrolarii, ea poate ocupa fix numarul cerut de tabel. `JOIN_REQ`-ul este atunci refuzat cu explicatie si cu solutia (`remove <DevEUI> force`), in loc sa se suprascrie in tacere inregistrarea altui senzor.
- **Capcana prinsa pe partea de senzor, si ea tratata in cod:** `DevEUI` se scria in HEF **doar la prima pornire** — daca randul de identitate avea marcajul, se citea si se iesea. O placa deja folosita, reprogramata cu alt `SENSOR_NODE_ID` (cazul obisnuit: senzorul #2 s-a ars si ii ia locul o placa de rezerva), si-ar fi pastrat identitatea VECHE din HEF, in timp ce cheia folosita ar fi fost cea compilata, a noului numar. Rezultatul: "MIC gresit" pe hub, cu o sursa perfect corecta pe disc — F-033 din nou, dar cu starea ne-volatila in loc de directorul de build. `Nvm_LoadOrCreateProvisioning()` compara acum `DevEUI`-ul din HEF cu cel compilat si, cand difera, rescrie randul de identitate **si sterge sesiunea**. Costa 28 de cuvinte si nicio scriere in plus la o pornire obisnuita: se compara doar.
- **Ce s-a schimbat pe hub odata cu trecerea la 5 senzori:** comanda noua **`sensors`** arata toate cele cinci locuri, si cele goale, cu ultima temperatura, varsta ei, RSSI si pachetele pierdute; `remove` accepta si forma scurta `remove #3`; fiecare linie de jurnal incepe cu `Senzor #N (0xNN)`; `serviceOfflineWatch()` anunta o data cand un senzor amuteste si o data cand revine. `DeviceRecord` a primit campuri noi, deci `REGISTRY_BLOB_VERSION` a trecut pe **3**: la primul boot registrul porneste gol si fiecare senzor trebuie reinrolat o data — dar isi primeste inapoi exact acelasi numar.
- **De retinut:** un identificator generat "in ordinea sosirii" este bun numai atat timp cat nimeni nu trebuie sa il tina minte. In clipa in care apare pe o eticheta lipita pe o cutie, el trebuie sa vina dintr-o configuratie, nu dintr-o istorie.

### F-038 — Criptografia nu mai lasa loc pentru nimic altceva; scoasa temporar
*(2026-08-29)*
- **Simptom:** nicio functionalitate noua nu mai incapea pe senzor. Firmware-ul ajunsese la **3876 din 3968 de cuvinte utilizabile (97,7%) si 232 din 256 de octeti de RAM**, adica **92 de cuvinte marja**. Orice adaugare — fie si o bucla de intarziere cu o constanta noua, care costa ~25 de cuvinte (F-030) — pica link-editarea cu `can't find N words for psect ... in class CODE`.
- **Cauza:** nu un bug, ci suma unei serii de decizii corecte pe un device prea mic. XTEA-128 cu CBC-MAC si CTR ocupa ~1300 de cuvinte si ~69 de octeti; peste ele se adunau `Key_UseApp()` (145 de cuvinte, pretul lui F-029), derivarea cheii, generarea nonce-ului, asamblarea intrarilor de MIC in cele patru functii de pachet, si cei 16 octeti de `AppKey` din memoria de program. Toate marjele fusesera deja consumate: AES-ul fusese inlocuit cu XTEA (F-024), aritmetica pe 32 de biti scoasa din codul fierbinte (F-028), `AppKey` mutat din RAM in HEF (F-029), buclele de intarziere unificate (F-030), `SPI1_Open` scos din legatura si frame counter-ul trecut pe `Word32` (F-034).
- **Fix — criptografia a fost scoasa integral, pe ambele capete, cu pairing-ul PASTRAT.** Rezultat masurat: **2395 de cuvinte si 95 de octeti**, adica **-1481 de cuvinte si -137 de octeti**, cu marja crescuta de la 92 la **1573 de cuvinte**. Ce s-a schimbat:
  - au disparut XTEA, CBC-MAC, CTR, `AppKey`, `SessKey`, `DevNonce`, `JoinNonce`, `HubCrypto.*` si comutatorul `PAIRING_ENCRYPT_PAYLOAD`;
  - pachetele s-au scurtat: `JOIN_REQ` 16 -> 10, `JOIN_ACCEPT` 10 -> 3, `DATA_ENC` 17 -> **`DATA_UP`** 13, `CMD_DOWN` 12 -> 4;
  - randul de sesiune din HEF s-a redus la MAGIC + `DevAddr`, iar `HEF_ROW_BUFFER_LEN` de la 25 la 9;
  - `REGISTRY_BLOB_VERSION` a trecut pe **4**;
  - pe hub, `findAppKey()` a devenit `isProvisioned()`, iar `PROVISIONED_DEVICES_INIT` a ramas o lista de DevEUI-uri.
- **Ce a RAMAS, si de ce inrolarea are in continuare rost:** ea creeaza intrarea in registrul hub-ului (fara care `remove` si dezinrolarea confirmata din F-031 nu ar exista), da senzorului bitul persistent "am voie sa vorbesc" (F-030), sincronizeaza originea contoarelor, dovedeste legatura radio in ambele sensuri o data, cu operatorul de fata, si confirma numarul dinspre autoritatea lui — tabelul din `Config.h` — spre placa. Este o **comisionare**, nu un control de acces, si asa trebuie descrisa peste tot.
- **Ce s-a PIERDUT, scris raspicat:** reteaua nu mai este autentificata. Oricine cu un radio pe aceiasi parametri poate injecta o temperatura falsa, poate dezinrola orice placa cu patru octeti (`A5 13 <DevAddr> 02`), poate inrola o placa falsa cat fereastra este deschisa, si poate rejuca orice pachet. Singura aparare ramasa pe calea de date este frame counter-ul strict crescator.
- **Trei capcane platite in timpul fixului:**
  1. **`Word32` nu se sterge odata cu cifrul.** Uniunea statea in sectiunea cifrului, dar o folosesc `Nvm_LoadFrameCounter`, `Nvm_SaveFrameCounter` si `Packet_BuildDataUp`. Stearsa din reflex, cele trei ar fi fost rescrise "cu shift-uri" si ar fi reintrodus ~300 de cuvinte (F-028) — o cincime din tot castigul, fara ca nimeni sa observe, fiindca marja e acum mare si nimic nu mai doare.
  2. **`HEF_MAGIC_SESSION` a trebuit schimbat de la `0xC3` la `0xC4`.** Randul de sesiune vechi incepea cu `0xC3` urmat de `DevAddr` — exact formatul nou, octet cu octet. Cu marcajul neschimbat, firmware-ul nou ar fi citit o sesiune veche ca valida si ar fi emis catre un hub al carui registru tocmai fusese golit de `REGISTRY_BLOB_VERSION = 4`: cinci placi blocate in `DevAddr ... nu este inrolat`, fiecare recuperabila doar cu trei secunde de buton, pe teren. Cu marcajul schimbat, ambele capete pornesc golite simultan si recuperarea este cea normala.
  3. **`RegMaxPayloadLength` a trebuit recalibrat.** Cat timp `DATA_ENC` avea 17 octeti si limita era 16, modemul arunca singur pachetele celorlalti senzori — jumatate din apararea ferestrei de downlink (F-035), obtinuta din intamplare. Cu pachete de 13 octeti filtrul ar fi disparut in tacere. `LORA_RX_BUFFER_LEN` a coborat la **6**, deci acum arunca si `DATA_UP` (13), si `JOIN_REQ` (10) ale celorlalti: filtru mai bun decat inainte.
- **Doua lucruri s-au imbunatatit ca efect secundar:** `DevAddr` circula acum in clar in `JOIN_ACCEPT`, deci senzorul poate filtra fereastra de join pe adresa — ce F-035 lasase dinadins netratat, fiindca adresa era cifrata. Si, tot de acolo, o placa programata cu un numar care nu corespunde randului ei din tabel isi refuza singura `JOIN_ACCEPT`-ul, ceea ce inlocuieste diagnosticul "MIC gresit" pierdut odata cu cifrul.
- **RECUPERARE:** ultima stare cu criptografie este commit-ul **`a710142`** ("codul 3 senzori"). De acolo se reintroduce cifrul dupa upgrade-ul de microcontroller. **Nu compensa intre timp cu nimic facut in casa** — un pseudo-MIC de o suta de cuvinte care nu opreste pe nimeni este mai rau decat o absenta onesta, fiindca cineva se va baza pe el.

---

### F-039 — Produsul traia intr-un test, si nimic nu rula fara un om la tastatura
- **Simptom:** hub-ul nu facea nimic la pornire. Inrolarea senzorilor si
  receptia temperaturilor — adica tot ce inseamna produsul — traiau in
  „testul 8" si porneau doar daca cineva tasta `8` in Serial Monitor.
  Ethernet-ul se ridica doar in interiorul testului 3 sau 6, deci pe un
  hub lasat singur nu exista nici retea.
- **Cauza:** structura era mostenita din faza de bring-up hardware, cand
  chiar asta se voia: un meniu din care se incearca un modul o data.
  Functionalitatea a crescut inauntrul ei in loc sa o inlocuiasca.
- **Fix:** cele sapte teste au fost **sterse** (`TestButtons`,
  `TestEncSpi`, `TestEthernet`, `TestLoRaTx`, `TestLoRaRx`,
  `TestCoexistence`, `TestSensorRx`), structura `Test` odata cu ele.
  `TestPairing.*` a devenit `SensorLink.*` si porneste din `setup()`;
  `TestBase.*` a devenit `Console.*` si a pastrat doar cele trei ajutoare
  de afisare; `EthernetLink.*` a devenit `NetLink.*`.
- **Ordinea din `setup()` este o decizie, nu o intamplare:** radioul
  porneste **inaintea** retelei si un esec de DHCP **nu opreste boot-ul**.
  Legatura cu senzorii este produsul; cloud-ul este un canal de raportare
  peste ea. Un hub fara cablu trebuie sa poata fi pus in functiune pe
  teren, altfel comisionarea depinde de un router.
- **De retinut:** cand functionalitatea reala ajunge sa fie „unul dintre
  teste", schela a devenit cladire. Ce se pierde nu este eleganta, ci
  faptul ca aparatul nu porneste singur.

### F-040 — Trei lucruri blocante in `loop()`, si de ce toate trei conteaza mai mult decat par
- **Simptom (prins la proiectare, inainte de a adauga reteaua):** hub-ul
  ar fi inceput sa piarda pachete si ACK-uri fara nicio eroare vizibila,
  in momente care nu se leaga de nimic — o tasta apasata, o reinnoire de
  lease, o cerere catre cloud.
- **Cauza, si cifra care schimba totul:** `LoRa.parsePacket()` din
  libraria Sandeep Mistry pune modemul in **RX_SINGLE**, nu in RX
  continuu. `RegSymbTimeout` are valoarea de reset 0x64 = 100 de
  simboluri, adica **~102 ms** la SF7/BW125. Dupa atat, modemul cade in
  standby. Prin urmare o blocare in `loop()` **nu intarzie receptia, o
  distruge**: pachetele nu se acumuleaza nicaieri, nu exista niciun FIFO
  care sa le tina. Peste asta se aduna fereastra de downlink a senzorului,
  care are 600 ms si este singura ocazie in care hub-ul poate raspunde.

  Cele trei blocari gasite:
  1. `Serial.readStringUntil('\n')` in consola — asteapta pana la
     `Stream::_timeout`, adica **o secunda**, daca terminalul este pe „No
     line ending". O secunda de surzenie, declansata de o tasta;
  2. `Ethernet.begin(HUB_MAC, 15000)` fara timeout de raspuns —
     `Ethernet.maintain()` **refoloseste** acele valori la reinnoirea
     lease-ului, iar acolo schimbul DHCP este blocant. Cincisprezece
     secunde, la zile dupa pornire, fara niciun avertisment;
  3. cererile HTTP, care sunt blocante prin proiectare.
- **Fix, cate unul pentru fiecare:**
  1. `SerialConsole::tick()` citeste **un octet per apel** intr-un
     `char[96]` si executa la Enter;
  2. `Ethernet.begin(HUB_MAC, 8000, 2000)`, `maintain()` limitat la o
     data pe secunda si **cronometrat** — peste `ETH_MAINTAIN_WARN_MS` =
     200 ms se scrie pe Serial cu durata, fiindca aici se masoara, nu se
     presupune;
  3. doua porti in `HubCloud::tick()`: nu se porneste nimic cat timp
     `millis() - SensorLink::lastRxMs() < HTTP_QUIET_AFTER_RX_MS`
     (fereastra de downlink tocmai deschisa), si nici cat timp
     `SensorLink::hasPendingRemoval()` (un RESET care isi asteapta
     fereastra, F-031).
  In plus, ACK-ul a fost mutat **inaintea** blocului de log din
  `handleData()`: linia de ~110 caractere costa ~9,5 ms la 115200 baud,
  cheltuiti din interiorul ferestrei degeaba.
- **De ce cererile HTTP au ramas totusi blocante:** `EthernetClient` din
  EthernetENC nu are `connect()` neblocant, deci o masina de stari ar fi
  pastrat oricum o gaura de peste o secunda; iar o sesiune intinsa pe mai
  multe `tick()`-uri ar lasa LoRa sa vorbeasca in mijlocul unui transfer
  Ethernet pe magistrala partajata. Costul masurat: ~4% surzenie, si numai
  cat timp cloud-ul este cazut. Pierderile se vad in coloana `pierd.`.
- **De retinut:** inainte de a pune ceva nou in `loop()`, intreaba cat
  blocheaza si compara cu 102 ms, nu cu „pare rapid".

### F-041 — `claimEthernet()` si `claimLoRa()` sunt aceeasi functie
- **Simptom:** niciunul inca — de aceea intrarea exista.
- **Cauza:** cele doua functii au corpuri identice: amandoua ridica
  ambele CS-uri. Ca **preconditie** („nimeni nu este selectat inainte sa
  incepi") sunt corecte si suficiente, fiindca fiecare biblioteca isi
  coboara singura CS-ul in propria tranzactie SPI. Ca **invariant** nu
  impun nimic: nimic nu impiedica un cod care uita `deselectAll()` pe o
  cale de eroare sa lase celalalt modul sa vorbeasca peste el.
- **Fix:** `SpiBus::Owner` — un flag care retine cine a cerut ultima data
  magistrala, plus un avertisment sub `SPI_BUS_ASSERT` (implicit 1) cand
  un modul o cere fara ca celalalt sa o fi eliberat. Se plange **o
  singura data per tranzitie gresita**, ca sa nu inece Serial-ul si sa
  devina el insusi o problema de temporizare. In plus, rezervarea SPI a
  fost stransa intr-un singur loc: `NetLink::acquireClient()` /
  `releaseClient()`, deci `Http` nu atinge niciodata `SpiBus`.
- **Ce NU s-a facut, dinadins:** un mutex. Programul are un singur fir de
  executie; un lacat ar transforma o eroare de proiectare intr-un blocaj
  care nu se poate depana pe Serial. Ramane valabil cat timp nimeni nu
  adauga un task FreeRTOS — in ziua aceea, discutia se redeschide.

### F-042 — Serverul raspunde `chunked`, si fara de-chunker hub-ul ar fi raportat la nesfarsit „baza de date nu raspunde"
- **Simptom (prins prin masurare, inainte de a ajunge pe placa):** cu un
  server perfect sanatos, hub-ul ar fi raportat la fiecare incercare
  „JSON invalid" sau „baza de date nu raspunde", si ar fi ramas
  neprovizionat pentru totdeauna. Nicio eroare de retea, niciun timeout —
  cererea reuseste, raspunsul vine, si totusi nu merge.
- **Cauza:** `GET http://84.117.97.136:7039/api/health` raspunde cu
  `Transfer-Encoding: chunked` si **fara** `Content-Length` — Kestrel
  emite chunked ori de cate ori nu stie lungimea din start. Un cititor
  care ignora codarea da lui ArduinoJson octetii `52\r\n{"status":...`,
  adica antetul de chunk lipit de JSON, si primeste `InvalidInput`.
- **Fix:** de-chunker in `Http.cpp`, ~25 de linii: lungimea in
  hexazecimal, atatia octeti, CRLF, pana la chunk-ul de lungime zero.
- **Cum s-a prins:** cu `curl -i` catre endpoint-ul real, inainte de
  prima programare a placii. Antetele raspunsului sunt cinci secunde de
  verificat si scutesc o zi de cautat un bug care arata ca o problema de
  retea si nu este.
- **A doua masuratoare din aceeasi sesiune:** aceeasi cerere de
  provisioning trimisa cu si fara `X-Solvix-AdminKey`, cu un `deviceUid`
  inexistent, a primit de ambele dati **exact acelasi** 401 cu mesajul de
  provisioning, nu o eroare generica de autentificare. Deci cererea
  ajunge la handler in ambele cazuri si cheia de admin nu este ceruta
  acolo; credentialul care conteaza este `provisioningSecret`.
  `CLOUD_PROVISION_SENDS_ADMIN_KEY` ramane pe 1, dar acum se stie ca
  trecerea pe 0 este sigura — si ea ar scoate cheia globala de admin din
  fiecare hub din teren, de unde oricine tine placa in mana o poate citi
  cu `esptool read_flash`.
- **De retinut:** un endpoint se masoara inainte de a fi implementat pe
  microcontroler. Formatul raspunsului si regulile de autentificare sunt
  doua intrebari la care `curl` raspunde imediat si presupunerile
  raspund gresit.

### F-043 — Un singur contor de esecuri: backoff-ul nu crestea niciodata, si hub-ul isi intretinea singur blocajul
- **Simptom, vazut pe placa la prima rulare cu serverul real:** hub-ul
  relua la nesfarsit acelasi ciclu, la fiecare ~11 secunde:
  `GET /api/health` 200 -> „Server sanatos" -> `POST /api/device/provision`
  **429** „Prea multe incercari esuate pentru acest device" ->
  „Reincerc peste **10 s**". Mereu 10 s, niciodata 30 sau 60, desi
  backoff-ul era scris ca 5 / 10 / 30 / 60.
- **Cauza, doua lucruri suprapuse:**
  1. **Un singur `s_failures` pentru doua lucruri diferite.** Verificarea
     de sanatate reusea de fiecare data si il punea pe **0**; esecul de
     provisioning care urma imediat il facea **1**. Deci `scheduleRetry()`
     alegea vesnic treapta a doua, 10 secunde. Backoff-ul exista in cod si
     nu putea creste, fiindca fiecare succes de pe o cale stergea
     istoricul celeilalte.
  2. **429 era tratat ca orice alt esec.** Dar un 429 nu spune „mai
     incearca", spune „incetineste": serverul numara **incercarile
     esuate** pentru acel device. Fiecare reincercare la 11 secunde
     adauga inca un esec la contorul dupa care usa ramane inchisa. Hub-ul
     nu doar ca nu iesea din blocaj, ci il **intretinea**, si nu avea nicio
     cale sa iasa singur vreodata.
- **Fix, trei masuri:**
  1. **doua contoare** — `s_healthFailures` si `s_provisionFailures`. Un
     succes pe o cale nu mai sterge istoricul celeilalte, deci backoff-ul
     chiar creste;
  2. **429 are tratamentul lui**: `scheduleCooldown()`, care respecta
     antetul `Retry-After` daca serverul il trimite si altfel asteapta
     `CLOUD_RATELIMIT_COOLDOWN_MS` = 15 minute. Se reintra **direct** in
     `Provision`, nu prin `Health`: stim deja ca serverul e sanatos,
     tocmai ne-a raspuns;
  3. **oprire dupa `CLOUD_PROVISION_MAX_ATTEMPTS` = 5 esecuri
     consecutive**, in starea `Blocked`, cu lista de verificat (device
     deja provizionat? secret consumat? fereastra de limitare?). Radioul
     ramane pornit — se pierde raportarea in cloud, nu produsul. Comanda
     `provision` reia, dupa ce omul a lamurit cauza.
- **De retinut, doua lucruri diferite:**
  - **Un contor care serveste doua cai de esec nu masoara niciuna.**
    Bug-ul nu se vede citind `scheduleRetry()`, care este corecta; se
    vede doar urmarind cine mai scrie in variabila.
  - **Reincercarea automata trebuie sa stie sa se opreasca.** Un
    mecanism de reincercare care nu poate distinge „mai incearca" de
    „incetineste" si nu are un capat transforma o eroare temporara intr-o
    stare permanenta pe care o produce el insusi.

### F-044 — `lifecycleStatus` avea loc pentru 16 caractere, iar prima valoare reala a serverului are 17
- **Simptom:** provisioning-ul era refuzat de hub, nu de server. Cererea
  reusea, raspunsul venea intreg si se parsa corect, dar se oprea la
  scrierea identitatii, cu mesajul: campul `lifecycleStatus` are 17
  caractere, dar incap 16.
- **Cauza:** `char lifecycleStatus[17]` inseamna **16 caractere plus
  terminator**, iar prima valoare pe care o trimite serverul,
  `"PendingActivation"`, are exact **17**. Dimensiunea fusese aleasa la
  proiectare dintr-o estimare, nu dintr-o valoare vazuta.
- **Fix:** `lifecycleStatus` a trecut la **[31]**, adica 30 de caractere
  utile — loc pentru nume de stare mai descriptive fara inca o
  recompilare.
- **A doua problema, gasita cu aceeasi ocazie si reparata odata cu ea:**
  `provisionedAt[33]` chiar incapea, dar cu numai **4** caractere de
  rezerva. `"2026-09-01T17:05:45.6069005Z"` are 28 — iar aceeasi data cu
  un decalaj numeric in loc de `Z`,
  `"2026-09-01T17:05:45.6069005+03:00"`, are **33** si nu ar mai fi
  incaput. Serverul foloseste azi UTC, dar asta nu este garantat nicaieri,
  iar simptomul ar fi fost identic: provisioning refuzat, cu server si
  placa in regula amandoua. A trecut la **[41]**.
- **Ce a functionat exact cum trebuia:** verificarea valorii intoarse de
  `strlcpy`. Fara ea, `lifecycleStatus` s-ar fi salvat trunchiat, in
  tacere, si ar fi fost gresit de fiecare data cand cineva s-ar fi uitat
  la starea hub-ului. Mesajul a spus si campul, si lungimea ceruta, si
  lungimea disponibila — adica tot ce trebuia ca fixul sa dureze un minut.
- **Nu s-a schimbat `IDENTITY_BLOB_VERSION`, si nu era nevoie:** cele sase
  siruri se salveaza in NVS ca **siruri** (`putString`/`getString`), nu ca
  parte din blob. Marimea tamponului din C este o proprietate a
  programului, nu a formatului salvat; doar `HubConfig`, singurul camp
  scris cu `putBytes`, ar cere o incrementare. Deci niciun hub nu trebuie
  reprovizionat din cauza acestei schimbari.
- **De retinut:** o dimensiune de tampon aleasa „cu ochiul" pentru un camp
  care vine prin retea este o presupunere, si trebuie tratata ca atare —
  scrisa alaturi cu marja ei, si verificata cu valorile reale ale
  serverului, nu cu cele imaginate. Un camp cu marja de 4 caractere este
  un camp care va crapa.

### F-045 — Consola neblocanta nu executa nicio comanda pe "No line ending"
- **Simptom:** dupa trecerea hub-ului pe runtime permanent, **nicio
  comanda din lista nu mai facea nimic**. Se scria `help`, `sensors`,
  `cloud` — si nu se intampla absolut nimic. Nici macar mesajul
  "Comanda necunoscuta", ceea ce este chiar indiciul: nu era o comanda
  gresit scrisa sau gresit dispecerizata, ci una care **nu ajungea
  niciodata sa fie executata**.
- **Cauza:** `SerialConsole::tick()` a fost scrisa sa citeasca octet cu
  octet si sa execute linia la `\n` sau `\r` (F-040). Serial Monitor are
  insa o setare de terminator de linie, iar pe **"No line ending"** nu
  trimite niciunul — doar caracterele comenzii. Octetii se adunau in
  `s_line` la nesfarsit si nu se ajungea niciodata la dispecerizare.

  **Este o regresie, si merita spus de ce nu s-a vazut mai devreme:**
  varianta veche folosea `Serial.readStringUntil('\n')`, care se intoarce
  si pe **timeout**, dupa o secunda. Adica exact defectul reparat de
  F-040 — blocarea buclei pentru o secunda — era si lucrul care facea
  consola sa mearga fara terminator. Inlocuindu-l, s-a pierdut tacut o
  toleranta pe care nimeni nu o ceruse explicit si de care depindea
  configuratia implicita a unui terminal.
- **Fix, trei parti:**
  1. **incheiere dupa liniste:** daca exista octeti in tampon si nu a mai
     venit niciunul de `CONSOLE_IDLE_FLUSH_MS` = 250 ms, linia se
     considera terminata. Valoarea vine din felul in care se poarta
     terminalele reale: Serial Monitor trimite linia intreaga ca o
     **rafala** cand apesi Send, deci o pauza de 250 ms inseamna sigur
     "gata"; un terminal brut trimite caracter cu caracter, dar acolo
     Enter trimite `\r` si terminatorul explicit rezolva oricum cazul.
     Nu taie deci o comanda tastata rar;
  2. **drenaj marginit:** pana la `CONSOLE_DRAIN_MAX` = 32 de octeti per
     `tick()` in loc de unul singur. Unul singur insemna un octet la
     ~5 ms, deci o comanda lipita din clipboard intra caracter cu
     caracter. Cei 32 sunt deja in tamponul UART, deci citirea lor nu
     asteapta nimic si bucla ramane neblocanta;
  3. **se spune o data**, la prima comanda preluata fara terminator, ca
     terminalul nu trimite unul si unde se schimba setarea. Comanda merge
     oricum, deci nu este o eroare — este exact informatia care lipsea.
- **De retinut:** cand inlocuiesti o functie de biblioteca cu una
  scrisa de mana, **poarta-se identic doar in cazurile la care te-ai
  gandit**. `readStringUntil()` avea un comportament pe timeout care nu
  aparea in niciun comentariu si de care depindea o configuratie
  implicita. Inainte de a scoate ceva "care doar blocheaza", intreaba ce
  altceva mai facea acel blocaj.

### F-046 — Curatenie: hub-ul redus la inregistrarea in retea si comunicarea cu senzorii
- **Nu este un bug, este o taiere ceruta.** Se noteaza fiindca sterge cod
  care a existat si fiindca doua dintre stergeri au consecinte care nu se
  vad din diff.
- **Ce s-a scos:**
  - **consola, de la 15 comenzi la 3.** Au ramas `pair`, `status` si
    `remove` (plus `help`). Au disparut `sensors`, `list`, `provisioned`,
    `stats`, `net`, `hub`, `cloud`, `health`, `provision`, `forget`,
    `mem`, `reboot`. `status` le inlocuieste pe cele sapte de afisare:
    tabelul senzorilor, o linie de retea, o linie de cloud si identitatea
    hub-ului;
  - **assert-ul `SpiBus::Owner`** (F-041), cu tot cu `SPI_BUS_ASSERT`;
  - **`SpiGuard`**, `printHexByte()`, `ETH_SPI_HZ*`,
    `LoRaRadio::sendText()` si `receive()`, `NetLink::resolve()`,
    `connectionsOpened()`, `dhcpRenewals()`, `SensorLink::isRunning()`,
    `onReading()`, `stop()`, `printStats()` si cele sapte contoare care
    nu mai erau citite de nimeni, `DeviceRegistry::printAll()` si
    `printProvisioned()`, `HubIdentity::print()` si `clear()`,
    `HubCloud::printStatus()`, `forceHealth()` si `forceProvision()`.
- **PRIMA CONSECINTA, si a cerut o schimbare de comportament:**
  `HubCloud` intra in `State::Blocked` dupa
  `CLOUD_PROVISION_MAX_ATTEMPTS` = 5 esecuri, si **singura iesire era
  comanda `provision`** (F-043). Stearsa comanda, `Blocked` ar fi devenit
  o fundatura reala: hub-ul ar fi ramas acolo pana la reprogramare, exact
  in cazul in care se ajunge acolo cel mai des — serverul care ne-a
  limitat cu 429.

  `Blocked` este acum doar treapta cea mai lunga de asteptare:
  `CLOUD_BLOCKED_RETRY_MS` = 30 de minute, apoi se reintra singur in
  `Health` cu contoarele pe zero. Castigul din F-043 ramane intreg — nu se
  mai hamareste serverul la 11 secunde — dar hub-ul isi revine fara nicio
  interventie.
- **A DOUA CONSECINTA:** `pairingCode` ar fi devenit invizibil odata cu
  comanda `hub`. El exista ca sa fie **citit de un om si tastat in
  aplicatie** ca sa revendice hub-ul; un cod de revendicare pe care nu il
  poate citi nimeni nu isi mai face treaba. A intrat deci in `status`,
  afisat intreg, alaturi de `hubGuid` si `lifecycleStatus`. `apiKey` nu se
  mai afiseaza deloc, nici macar mascat: pe el nu are de ce sa il citeasca
  nimeni.
- **Ce NU s-a atins, dinadins:** `SensorPacket.*` (oglinda protocolului din
  `senzor/main.c`), structura `DeviceRecord` si `REGISTRY_BLOB_VERSION` = 4
  — o schimbare acolo ar fi cerut reinrolarea manuala a fiecarui senzor din
  teren (F-037) — layout-ul NVS al identitatii si
  `IDENTITY_BLOB_VERSION` = 1, cele doua porti din `loop()`, ordinea din
  `setup()` si LED-urile.
- **Cifre:** 5532 -> ~5000 de linii. Flash 358,7 kB -> 349,8 kB (-8,9 kB).
- **De retinut:** cand tai o comanda, intreaba intai **ce stare din
  program depindea de ea ca sa poata fi parasita**. Aici o singura
  stergere ar fi transformat o stare temporara intr-una permanenta, si
  nimic din diff nu ar fi aratat asta.

## 4. Criterii de acceptanta

Fotografie a ce s-a verificat, la 2026-08-29. Randurile taiate sunt cerinte
care **nu mai sunt acoperite** dupa F-038 — se pastreaza ca sa se vada exact
ce s-a pierdut odata cu cifrul.

| Cerinta | Unde este acoperita |
|---|---|
| Un senzor provizionat se inroleaza **doar** cand hub-ul e in mod pairing | `TestPairing::handleJoinRequest()`, prima verificare |
| Un senzor neprovizionat e respins | idem, `DeviceRegistry::isProvisioned()` |
| ~~Un senzor cu MIC gresit e respins~~ | **NU MAI ESTE ACOPERIT** (F-038): apartenenta la lista de provisioning este declarata, nu dovedita |
| Temperatura trece prin `decode()` existent, acelasi ca la testul 7 | `TestPairing::handleData()` |
| ~~Un `JOIN_REQ` rejucat e respins~~ | **NU MAI ESTE ACOPERIT** (F-038): `DevNonce` a disparut odata cu derivarea cheii |
| Un `DATA_UP` rejucat e respins | verificarea `frameCounter > lastFrameCounterUp` — singura aparare ramasa pe calea de date |
| Dupa reset de alimentare, senzorul reia comunicarea fara re-pairing si fara reutilizarea unui counter | HEF + saltul cu `FCNT_CHECKPOINT_EVERY` |
| `remove <DevEUI>` + `RESET` dezinroleaza curat, **si dezinrolarea este confirmata, nu presupusa** | `commandRemove()` marcheaza; `handleData()` retrimite `RESET` la fiecare pachet al device-ului marcat; `servicePendingRemovals()` sterge abia dupa `REMOVE_CONFIRM_SILENCE_MS` de tacere (F-031) |
| Downlink-ul ajunge efectiv la senzor | fereastra de receptie se deschide imediat dupa TX, fara nicio intarziere blocanta (F-032) |
| Un `RESET` pierdut nu lasa senzorul blocat in retea | inregistrarea se pastreaza cat timp senzorul se aude, deci hub-ul poate reincerca oricat (F-031) |
| `remove` pe un senzor oprit nu blocheaza registrul | `commandRemove()` refuza marcarea daca `hasUplink` este fals si trimite operatorul la `force` |
| Registrul hub-ului persista peste repornire | `DeviceRegistry` pe NVS |
| Senzorul se inroleaza **doar la cererea explicita a utilizatorului** | `DEV_STATE_IDLE` este starea implicita; fereastra se deschide numai din `ButtonPair_HeldLong()` si se inchide dupa `PAIRING_MAX_ATTEMPTS` incercari |
| Dupa `CMD_DOWN(RESET)` senzorul nu se re-inroleaza singur | ramura `CMD_TYPE_RESET` trece in `DEV_STATE_IDLE`, nu in `DEV_STATE_JOINING` |
| Inrolat, senzorul **doarme** intre transmisii | `Sleep_Cycle()`, chemata la finalul ciclului din `DEV_STATE_OPERATING`; trezire pe WDT, fara timer si fara rutina de intrerupere |
| Somnul **nu** inghite fereastra de downlink | `Sleep_Cycle()` se cheama abia dupa ce fereastra s-a inchis si eventualul `CMD_DOWN` a fost tratat (F-032) |
| Butonul raspunde si in timpul somnului | somnul e fragmentat in reprize de ~2,11 s, cu butoanele citite la fiecare trezire; RC5 este pe PORTC, iar acest device NU are interrupt-on-change pe PORTC |
| Dupa `CMD_DOWN(RESET)` senzorul ramane **treaz** in repaus | bucla sare peste somn cand `deviceState != DEV_STATE_OPERATING` |
| Somnul nu strica anti-replay-ul | `SLEEP` pastreaza RAM-ul, deci schema de checkpoint din F-022 ramane neschimbata |
| Hub-ul tine **5 senzori** simultan | `HUB_MAX_SENSORS` = 5; `PROVISIONED_DEVICES_INIT` are cele 5 randuri |
| Fiecare senzor are un **numar stabil**, care nu depinde de istorie | `DeviceRegistry::addressForEui()` (F-037) |
| Se stie **de la ce senzor SPUNE ca vine** fiecare masuratoare | `DevAddr` in octetul `[2]` din `DATA_UP`. **Atributia este declarativa, nu dovedita** (F-038) |
| Senzorii **nu emit sincronizat**, si nici nu raman ciocniti daca s-au ciocnit o data | Interval propriu din `DevAddr` plus jitter aleator, in `Sleep_Cycle()` (F-036) |
| Un pachet al altui senzor **nu inchide** fereastra de downlink | Filtrul `wantType` + `wantLen` + `devAddr` din `LoRa_Receive()`, plus filtrul hardware `RegMaxPayloadLength` (F-035) |
| Coliziunile sunt **vizibile**, nu tacute | Golurile din frame counter se numara ca `lostPackets`; apar in `sensors` si in `stats` |
| Un senzor care **cade** este semnalat | `serviceOfflineWatch()` anunta o data tacerea si o data revenirea |
| Dezinrolarea prin tacere **rezista** intervalelor de somn diferite | `REMOVE_CONFIRM_SILENCE_MS` = 180 s (F-036) |
| Reprogramarea unei placi cu alt numar chiar schimba identitatea | `Nvm_LoadOrCreateProvisioning()` (F-037) |
| Firmware-ul senzorului **incape** in PIC16LF1508 | **VERIFICAT**, cifrele in [MEMORY.md](MEMORY.md) |
| Reteaua **nu** este autentificata | **ASUMAT EXPLICIT** (F-038) |
| Hub-ul porneste si ruleaza **fara niciun om la tastatura** | `SensorLink::begin()` se cheama din `setup()`, nu dintr-un meniu (F-039) |
| Un hub **fara retea** poate fi totusi pus in functiune | `NetLink::begin()` esueaza fara sa opreasca boot-ul; radioul porneste inaintea lui (F-039) |
| Nimic din `loop()` nu tine hub-ul surd peste fereastra de downlink | consola citeste un octet per apel; `HubCloud` si `NetLink::maintain()` trec prin `lastRxMs()` si `hasPendingRemoval()` (F-040) |
| O reinnoire DHCP blocanta se **vede**, nu doar se banuieste | `maintain()` este cronometrat si raporteaza peste `ETH_MAINTAIN_WARN_MS` (F-040) |
| O conexiune TCP scursa se vede inainte sa lase hub-ul fara retea | `releaseClient()` face `stop()` neconditionat; comanda `net` arata deschise/inchise (F-040) |
| Hub-ul se provizioneaza singur, o singura data | `HubCloud`: health -> provision -> NVS; a doua pornire nu mai cere nimic. Comanda `provision` refuza daca e deja facut |
| Serverul este considerat bun doar daca **baza de date** raspunde | se compara campul `database` cu `Reachable`, nu campul `status` (F-042) |
| O identitate scrisa pe jumatate arata ca una lipsa | versiunea se scrie ultima si se sterge prima; `isProvisioned()` cere versiune + `hubGuid` + `apiKey` |
| Secretele nu ajung pe Serial | `apiKey` mascat, `provisioningSecret` deloc; corpul unui raspuns nevalid nu se afiseaza integral |
