SolviX-IoT/nou_hub_senzoor_pairing/(commit log)

2026-08-23 Pairing criptat senzor-hub, incadrat in PIC16LF1508
    Sistem cu doua noduri pe LoRa 868 MHz: un senzor de temperatura pe
    PIC16LF1508 care se inroleaza la un hub ESP32 si trimite apoi date
    cifrate, cu registru persistent si dezinrolare de la hub.
    Peste functionalitatea de temperatura, care ramane neatinsa:
    - inrolare (JOIN_REQ / JOIN_ACCEPT) cu cheie de sesiune derivata;
    - date cifrate (DATA_ENC) cu MIC pe fiecare pachet si anti-replay;
    - registru de senzori pe hub, salvat in NVS;
    - dezinrolare cu CMD_DOWN(RESET), comanda `remove` pe Serial;
    - receptie LoRa pe senzor, care inainte era doar emitator;
    - memorie ne-volatila pe senzor, in HEF.
    Cifrul este XTEA-128 cu CBC-MAC si CTR, nu AES: masur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
    [Config.h, SensorPacket.cpp, SensorPacket.h, SolvixHub_Tests.ino, TestBase.cpp, TestPairing.cpp]
2026-08-25 Pairing manual pe senzor, declansat din butonul 2 (F-030)
    Senzorul nu se mai inroleaza singur. Fara sesiune in HEF intra in
    DEV_STATE_IDLE si tace; fereastra de pairing se deschide tinand butonul 2
    (RC5) apasat ~3 secunde si se inchide dupa PAIRING_MAX_ATTEMPTS = 10
    incercari de join. DEV_STATE_JOINING inseamna de acum "fereastra este
    deschisa", nu "incerc la nesfarsit".
    - ButtonPair_HeldLong(): numara 30 x 100 ms pe RC5 intr-un uint8_t, cu
    LED2 clipind; o apasare scurta nu face nimic. Fereastra se masoara in
    incercari, nu in milisecunde, ca sa nu apara un uint32_t nou in codul
    fierbinte (F-028).
    - RC5 se asculta si in bucla de date, ca reinrolarea sa nu ceara
    scoaterea placii din p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
2026-08-25 Dezinrolare confirmata pe hub: RESET retrimis pana la tacere (F-031)
    `remove` era "trimite si uita": handleEncryptedData() trimitea un singur
    CMD_DOWN(RESET) si stergea imediat inregistrarea. Downlink-ul are o
    singura sansa - senzorul asculta doar DOWNLINK_WINDOW_MS = 600 ms dupa
    fiecare transmisie - iar odata cu inregistrarea hub-ul arunca si cheia de
    sesiune, adica singurul mod de a mai compune un CMD_DOWN valid pentru
    device-ul acela. Un RESET pierdut lasa senzorul emitand la nesfarsit, cu
    hub-ul incapabil sa il mai opreasca; iesirea ramanea fizica, de la butonul
    2 al senzorului.
    Stergerea se face acum pe dovada, nu pe speranta:
    - inregistrarea si cheia se pastreaza dupa trimiterea RESE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
    [Config.h, SolvixHub_Tests.ino, TestPairing.cpp]
2026-08-25 Fereastra de downlink se deschide imediat dupa TX (F-032)
    Simptom: hub-ul retrimitea CMD_DOWN(RESET) la fiecare pachet - incercarea
    1, 2, 3, 4, 5... - iar senzorul continua netulburat sa emita DATA_ENC.
    Nici ACK-urile nu ajungeau vreodata, desi PAIRING_SEND_ACK = 1. Inrolarea
    mergea insa din prima de fiecare data.
    Cauza: intre LoRa_SendBuffer() si LoRa_Receive(), in bucla de date, statea
    Led_PulseData() - un puls BLOCANT de LED_PULSE_MS = 150 ms. Fereastra de
    receptie se deschidea deci abia la 150 ms dupa terminarea propriei
    transmisii, iar hub-ul raspunde mult mai devreme: cateva ms de procesare
    si Serial, plus ~41 ms de timp pe aer pentru cele 12 octeti ale lui
    CMD_DOWN la SF7/BW125/CR4/5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
    [main.c]
2026-08-25 F-033: build de verificare in build/+dist/ lasa MPLAB X cu o stare veche
    Doua "bug-uri" care nu existau: intai butonul 2 parea mort (RC5 tinut trei
    secunde, nimic), apoi senzorul parea ca se inroleaza singur - adica exact
    comportamentul de dinainte de F-030. S-a cautat in maparea pinilor, in
    pull-up-uri (PIC16LF1508 nici nu are WPUC) si in cablaj. Sursa era corecta
    tot timpul; placa era programata cu cod vechi.
    Cauza: build-urile de verificare a incadrarii au fost facute chemand
    xc8-cc direct, cu iesirea scrisa fix in senzor/build/ si senzor/dist/,
    adica directoarele de lucru ale lui MPLAB X. Numele obiectelor nu erau
    cele asteptate de Makefile-default.mk, iar in dist/ ramanea un .elf mai
    n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
2026-08-25 CLAUDE.md: audit de coerenta dupa F-030...F-033
    Sectiunile care nu fusesera atinse de commit-urile precedente ramasesera
    sa descrie comportamentul vechi:
    - sectiunea 1: stergerea este acum CONFIRMATA prin tacere, nu "RESET la
    primul contact";
    - sectiunea 5.8: dupa RESET senzorul ajunge in DEV_STATE_IDLE, nu direct
    in starea de inrolare; adaugat ca hub-ul retrimite CMD_DOWN la fiecare
    pachet si ca intre transmisie si fereastra de receptie nu are voie sa
    stea nimic blocant (F-031, F-032);
    - sectiunea 7.2: DeviceRecord tine si resetAttempts / resetSentMs;
    explicat de ce lastSeenMs si resetSentMs se zeroizeaza la incarcarea din
    NVS, si care este pretul incrementarii lui REGISTRY_BLO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
2026-08-26 Somn intre transmisii pe senzor (F-034), plus scoaterea TPL5110
    Doua lucrari care au ajuns in acelasi commit fiindca se suprapun in
    aceleasi fisiere si, mai ales, fiindca cifrele de memorie din CLAUDE.md si
    README au fost rescrise de amandoua. Un commit separat pentru TPL5110 ar
    fi cerut sa reconstruiesc o stare a documentatiei pe care nu am
    compilat-o niciodata.
    --- TPL5110 scos din proiectare (componenta nu mai este pe placa) ---
    Sterse: cele trei scrieri de registre din Board_Initialize(), blocul de
    #define TPL5110_DONE_*, notele din antetul main.c si din sectiunea 5,
    main_powercycle_test.c.bak si senzor/Datasheets/ (folderul a ramas gol).
    RC1 devine pin liber si NU primeste cod: ramane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
2026-08-29 Criptografia scoasa, pairing-ul pastrat (F-038)
    Firmware-ul senzorului ajunsese la 3876 din 3968 de cuvinte utilizabile
    (97,7%) si 232 din 256 de octeti de RAM, adica 92 de cuvinte marja: nicio
    functionalitate noua nu mai incapea. Toate reducerile posibile fusesera
    deja facute (F-024, F-028, F-029, F-030, F-034), deci singura rezerva
    ramasa era cifrul insusi.
    XTEA-128 cu CBC-MAC si CTR a fost scos integral, de pe ambele capete,
    PASTRAND inrolarea. Masurat cu xc8-cc v3.10, -O2, cu HEF rezervat:
    Production 3876 -> 2395 words 232 -> 95 bytes
    Debug (Snap) 3877 -> 2396 words 232 -> 95 bytes
    Adica -1481 de cuvinte si -137 de octeti, cu marja de la 92 la 1573 de
    cuvinte. Ultimul cuvant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
    [Config.h, SensorPacket.cpp, SensorPacket.h, SolvixHub_Tests.ino, TestPairing.cpp, main.c]
2026-08-30 docs(docs): CLAUDE.md impartit in CLAUDE.md + MEMORY.md + ISTORIC.md
    CLAUDE.md ajunsese la 1687 de linii (108 KB) si se incarca integral in
    fiecare sesiune. Jumatate era arhiva: sectiunea 9 (istoricul F-001..F-038,
    640 de linii) plus sectiunea 13 (Jurnalul, 185 de linii), care repovestea
    aceleasi F-030...F-038 inca o data ca proza cu data. Devenise imposibil de
    citit si incepuse sa se desincronizeze de cod.
    Impartire in trei fisiere:
    - CLAUDE.md (508 linii) - referinta activa: prezentare, pini, parametri
    radio, protocol, memorie ne-volatila, rolul fiecarui fisier, cele 17
    reguli de cod, 5 reguli noi de colaborare, conventia de commit si regula
    de actualizare. Singurul incarcat automat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
2026-09-26 docs(docs): CLAUDE.md redus la reguli, restul mutat in MEMORY.md
2026-09-26 refactor(hub): comaseaza cele 28 de fisiere in 16, pe domenii
